adafruit/Adafruit-BH1750-PCB/Adafruit BH1750.brd

## EAGLE design Adafruit BH1750.brd (2020-08-07)

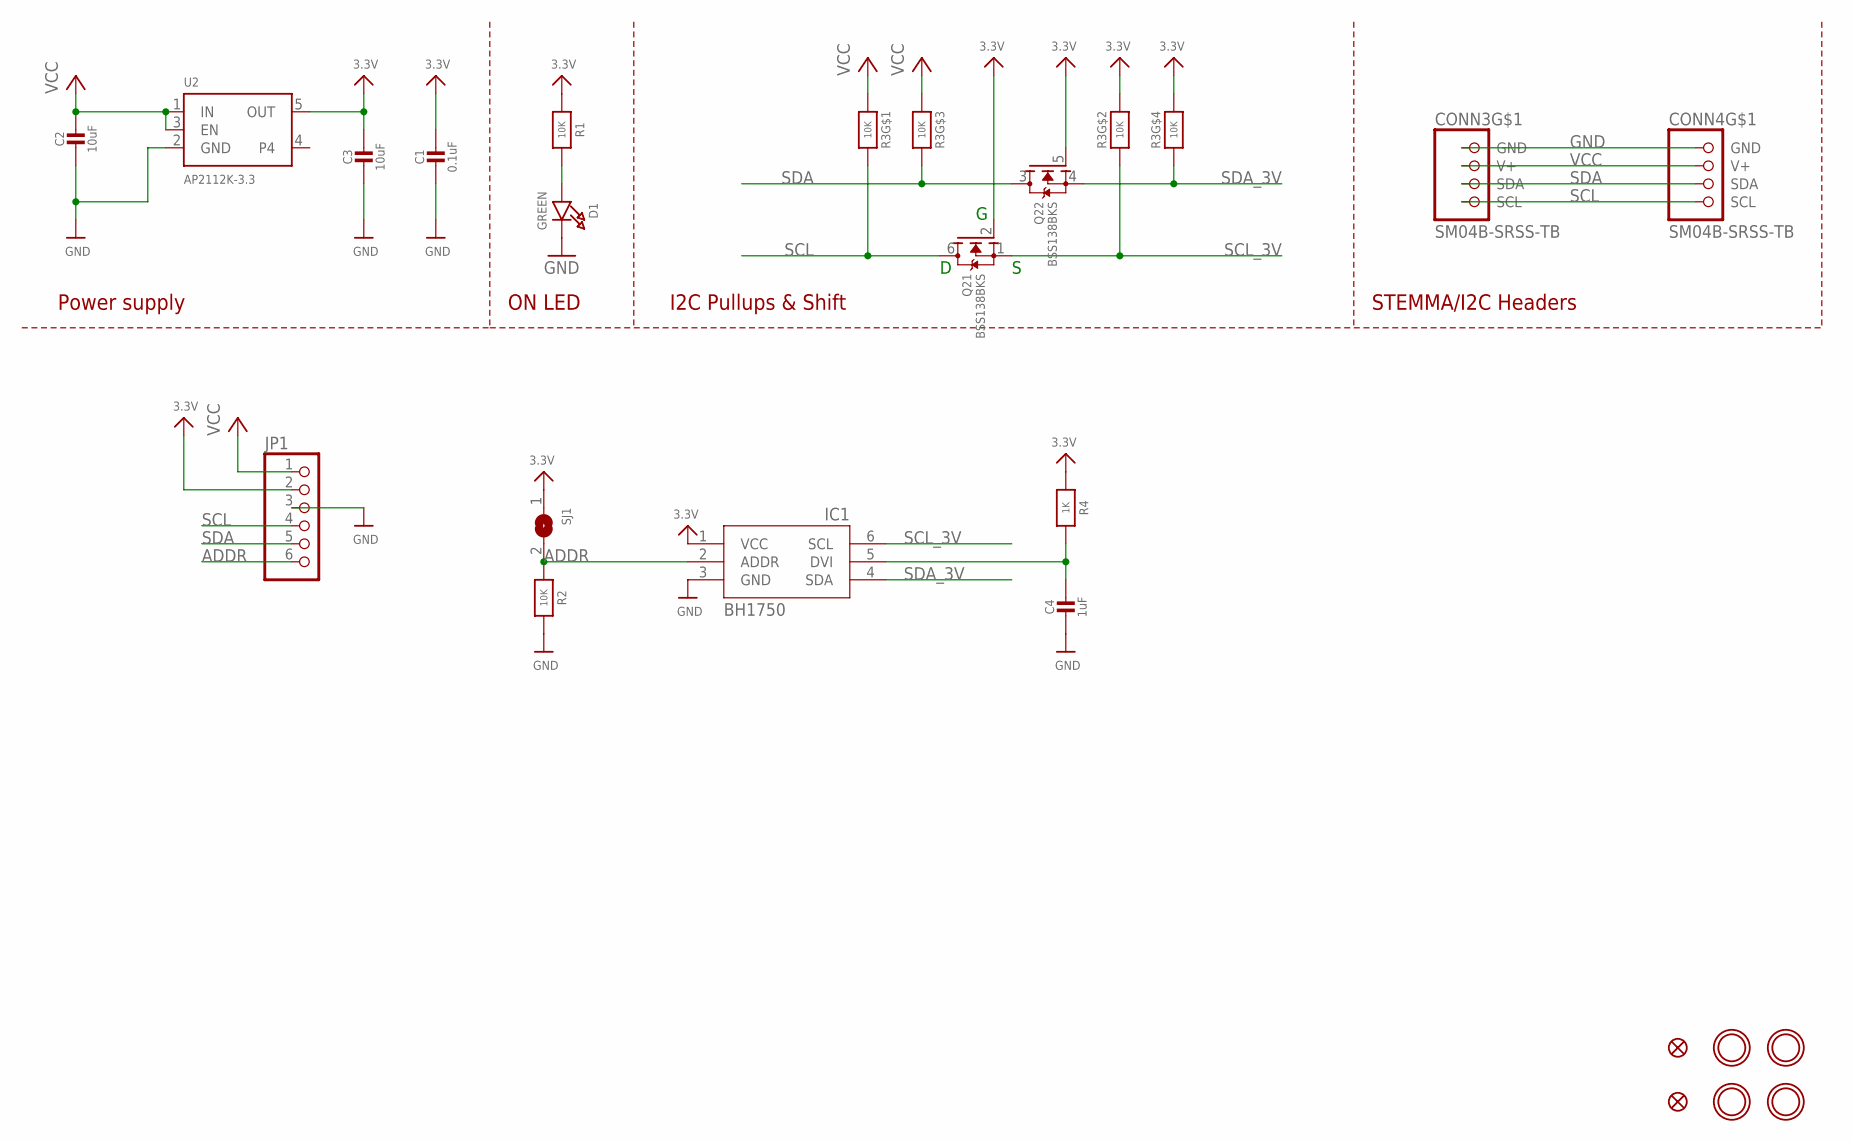
[picture p2: schematic Adafruit BH1750.sch]

Parts:
C1: 0.1uF; 0603-NO
C2, C3: 10uF; 0805-NO
C4: 1uF; 0603-NO
CONN3, CONN4: SM04B-SRSS-TB; JST_SH4
D1: GREEN; CHIPLED_0603_NOOUTLINE
FID3, FID4: FIDUCIAL_1MM
IC1: BH1750; WSOF-6
JP1: HEADER-1X670MIL; 1X06_ROUND_70
Q2: BSS138BKS; SOT363
R1, R2: 10K; 0603-NO
R3: 10K; RESPACK_4X0603
R4: 1K; 0603-NO
SJ1: SOLDERJUMPER; SOLDERJUMPER_ARROW_NOPASTE
U2: AP2112K-3.3; SOT23-5
U$1, U$17, U$19, U$21: MOUNTINGHOLE2.5; MOUNTINGHOLE_2.5_PLATED

Connections:
3.3V: C1.1, C3.1, IC1.1 (VCC), JP1.2, Q2.2 (G), Q2.5 (G), R1.1, R3.2 (1), R3.4 (1), R4.1, SJ1.1, U2.5 (OUT)
ADDR: IC1.2 (ADDR), JP1.6, R2.1, SJ1.2
GND: C1.2, C2.2, C3.2, C4.2, CONN3.1 (GND), CONN4.1 (GND), D1.C, IC1.3 (GND), JP1.3, R2.2, U2.2 (GND)
unnamed: D1.A, R1.2
unnamed: C4.1, IC1.5 (DVI), R4.2
SCL: CONN3.4 (SCL), CONN4.4 (SCL), JP1.4, Q2.6 (D), R3.8 (2)
SCL_3V: IC1.6 (SCL), Q2.1 (S), R3.7 (2)
SDA: CONN3.3 (SDA), CONN4.3 (SDA), JP1.5, Q2.3 (D), R3.6 (2)
SDA_3V: IC1.4 (SDA), Q2.4 (S), R3.5 (2)
VCC: C2.1, CONN3.2 (V+), CONN4.2 (V+), JP1.1, R3.1, R3.3 (1), U2.1 (IN), U2.3 (EN)

Notes on the sheet:
I2C Pullups & Shift
STEMMA/I2C Headers
ON LED
Power supply

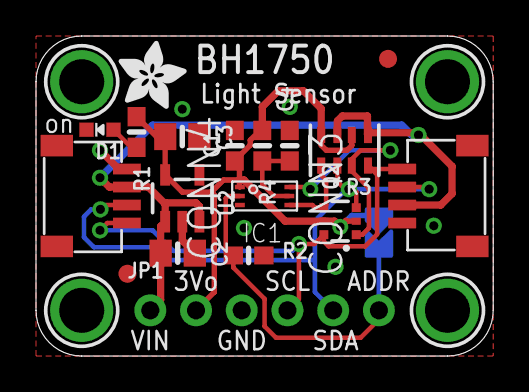
[picture p3: board Adafruit BH1750.brd from above]

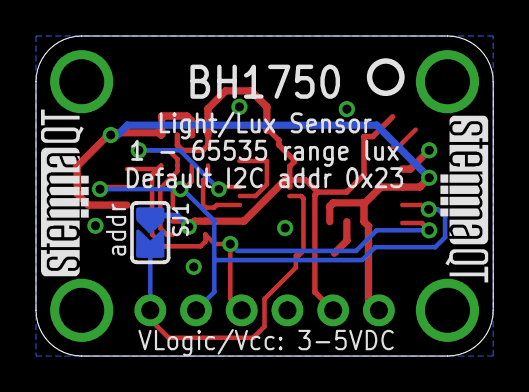
[picture p4: board Adafruit BH1750.brd from below]

Board: 2 copper layers, 25.4 x 17.8 mm, 26 parts (4 on the bottom side), 10 nets.

Other parts of the board:
U$22: ADAFRUIT_3.5MM
U$25: PCBFEAT-REV-040
U$30, U$31: STEMMAQT
