adafruit/Adafruit-BH1750-PCB/(threads)

Thread 1 (2022-01-30):

No values when using with Feather RP2040 and Arduino

rltvty, 2022-01-30:
I can't get any output on this board other than `0.00` when using this sensor with Feather RP2040 and the recommended Arduino library.

I've tried with 2 different BH1750 boards, and 2 different Feather RP2040's.

I'm connected to the sensor with stemma, and using the following sketch:

```
//for help look at: https://github.com/Starmbi/hp_BH1750/wiki
#include <Arduino.h>
#include <hp_BH1750.h>  //inlude the library
hp_BH1750 BH1750;       //create the sensor object

bool avail = false;

void setup()
{
  // put your setup code here, to run once:
  Serial.begin(9600);

  // setup i2c for adafruit feather RP2040
  Wire1.setSDA(2);
  Wire1.setSCL(3);

  avail = BH1750.begin(BH1750_TO_GROUND, &Wire1);   // will be false no sensor found
  if (avail) {
    // BH1750.calibrateTiming();  //uncomment this line if you want to speed up your sensor
    BH1750.start();               //start the first measurement in setup
  }
}

void loop()
{
  // put your main code here, to run repeatedly:
  if (avail) {
    if (BH1750.hasValue() == true) {    // non blocking reading
      float lux = BH1750.getLux();
      Serial.println(lux);
      BH1750.start();
    }
  } else {
    Serial.println("not available");
  }
  //  do a lot of other stuff here, while sensor is waiting for the result...
  delay(100);
}
```

ladyada, 2022-01-30:
whats the output of the i2c scan?
https://github.com/adafruit/Adafruit_TestBed/blob/master/examples/I2C_Scan/I2C_Scan.ino

rltvty, 2022-01-31:
This is my first time doing this, so let me know if I've done something wrong.

I added code from the example to my sketch, since running the example alone didn't seem to do anything.  Here is my current sketch:

```
//for help look at: https://github.com/Starmbi/hp_BH1750/wiki
#include <Arduino.h>
#include <hp_BH1750.h>  //inlude the library
#include <Adafruit_TestBed.h>
extern Adafruit_TestBed TB;

#define DEFAULT_I2C_PORT &Wire
#define SECONDARY_I2C_PORT &Wire1

hp_BH1750 BH1750;       //create the sensor object

bool avail = false;

void setup()
{
  Serial.begin(115200);

  // Wait for Serial port to open
  while (!Serial) {
    delay(10);
  }
  delay(500);

  // setup i2c for adafruit feather RP2040
  Wire1.setSDA(2);
  Wire1.setSCL(3);

  avail = BH1750.begin(BH1750_TO_GROUND, &Wire1);   // will be false no sensor found
  if (avail) {
    // BH1750.calibrateTiming();  //uncomment this line if you want to speed up your sensor
    BH1750.start();               //start the first measurement in setup
  }
}

void loop()
{
  // put your main code here, to run repeatedly:
  if (avail) {
    if (BH1750.hasValue() == true) {    // non blocking reading
      float lux = BH1750.getLux();
      Serial.println(lux);
      BH1750.start();
    }
  } else {
    Serial.println("not available");
  }
  //  do a lot of other stuff here, while sensor is waiting for the result...

  Serial.print("Default port ");
  TB.theWire = DEFAULT_I2C_PORT;
  TB.printI2CBusScan();

  Serial.print("Secondary port ");
  TB.theWire = SECONDARY_I2C_PORT;
  TB.printI2CBusScan();

  delay(3000);
}
```
Scan output:
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
* still nothing but has a label at least.

Serial output:
```
9:34:46.653 -> Default port I2C scan:
9:34:49.686 -> Secondary port I2C scan: 0x23,
9:34:49.686 -> 0.00
9:34:49.686 -> Default port I2C scan:
9:34:52.752 -> Secondary port I2C scan: 0x23,
9:34:52.752 -> 0.00
```

* `0x23` is the address of the I2C address of the BH1750

ladyada, 2022-01-31:
there's an extra line that should be removed, we submitted a PR
https://github.com/Starmbi/hp_BH1750/pull/4/files
you can manually perform the line deletion and it would start to work

rltvty, 2022-01-31:
thanks!

Closed 2022-01-31.
